shawCampbell/Light-and-Scent-repellent-system-to-deter-Honey-Badgers-from-the-Penguin-Colony/Group 31 Presentation Slides.pptx

## “How to keep predators, particularly honey badgers, away from the fence and the penguins??”

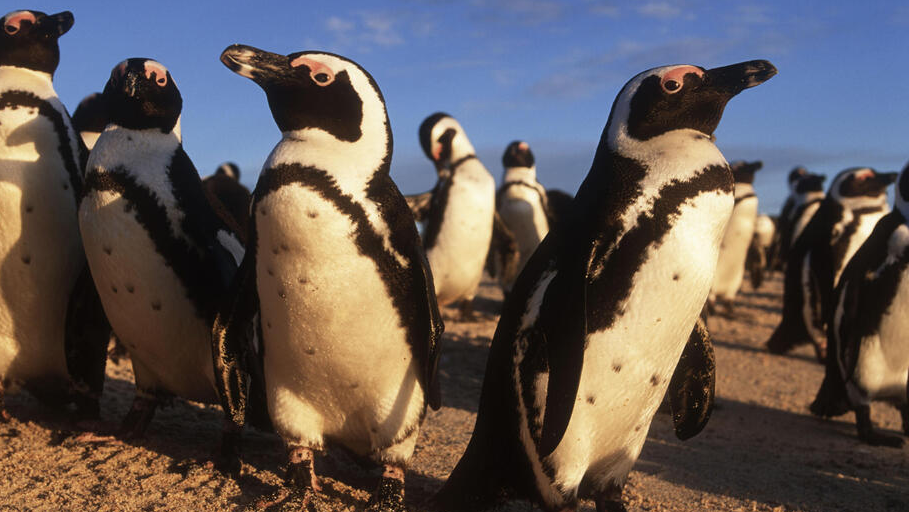
[picture p2: figure]

Group 31

## INSIGHT FROM THE LITERATURE

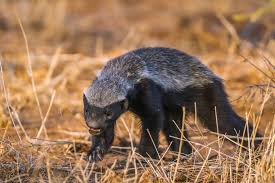
[picture p3: figure]
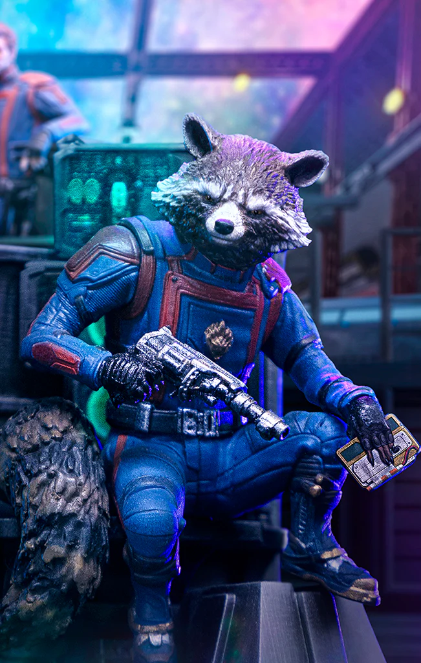
[picture p4: figure]

1. The world’s most fearless animal
2. Courageous, aggressive, strong and
SMART!!
Weaknesses:
1. Nocturnal
2. Heavily rely on smell for hunting
3. Repelled by certain scents e.g Citronella oil, garlic, vinegar etc

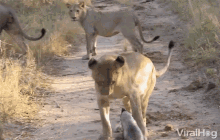
[picture p5: figure]

## Proposed solution: Honey Badger Repellent System

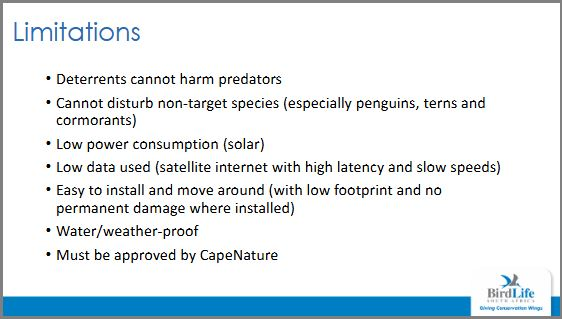
[picture p6: figure]

- Light and scent as a repellent
- Periodically spray the vicinity to desensitize the colony
- Once animal detected – turn on the strobing lights and power the spray

## Overview

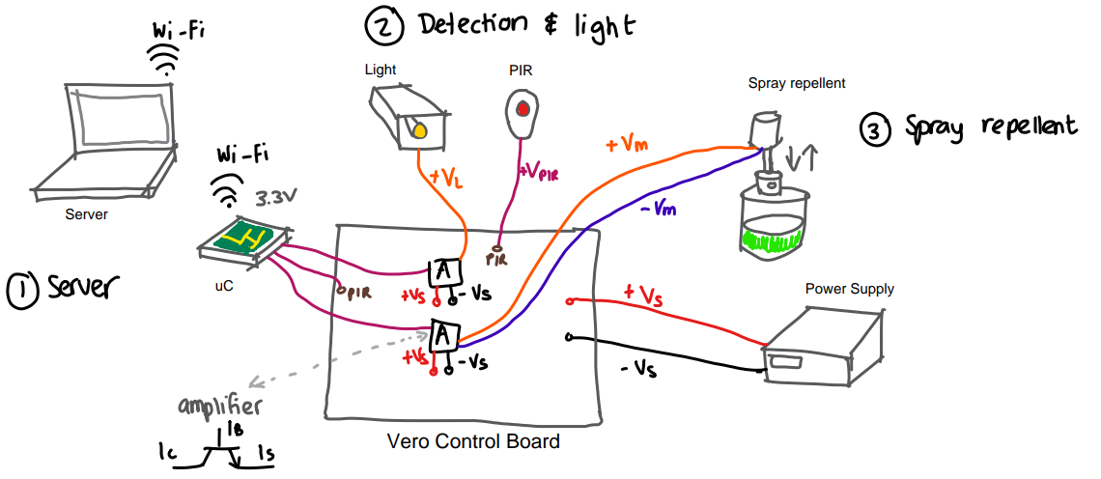
[picture p7: figure]

Overview of System

## Animal Detection Subsystem

Light sensor
*Power efficiency
*Increases electronics’ lifespan

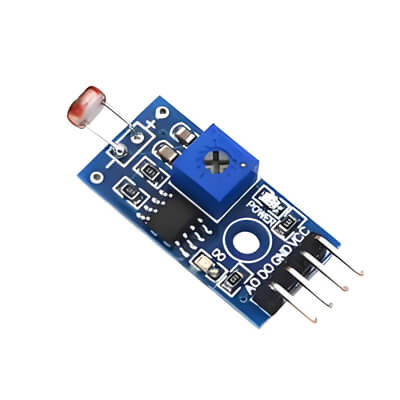
[picture p8: figure]

Passive Infrared (PIR)
*Common use in literature
*Long-range detection

IR Break beam sensor
* Short-range detection

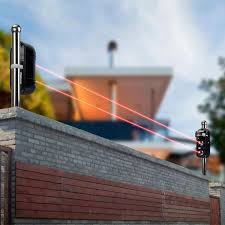
[picture p9: figure]
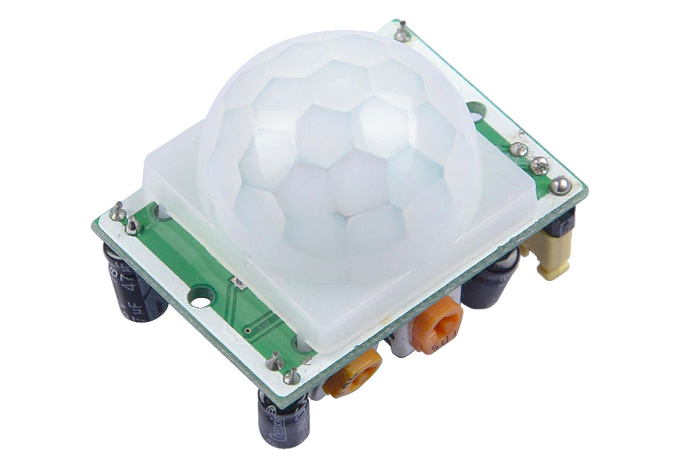
[picture p10: figure]

Sequential logic of operation:

Light sensor

PIR sensor

IR Break beam

ANIMAL DETECTED!!

## Networking and User Interface Subsystem

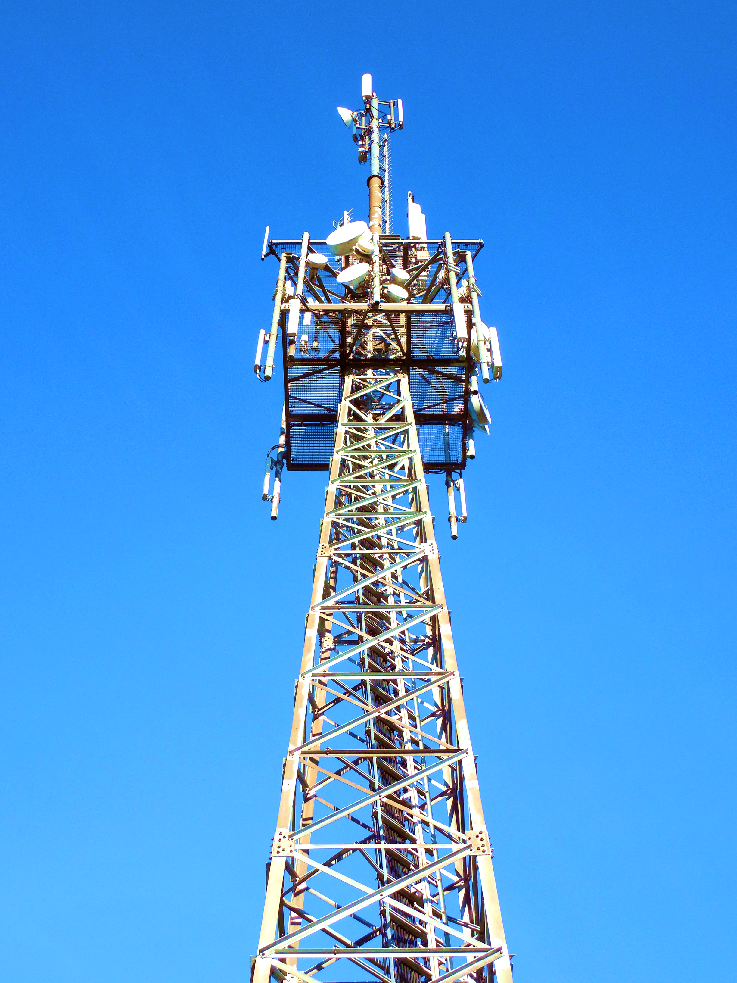
[picture p11: figure]
무료 이미지 : 변하기 쉬운, 범위, 차량, 탑, 돛대, 수신, 뉴스, 배달, 보내다, 전송 타워, 무선 기술, 송신기, 라디오 ...
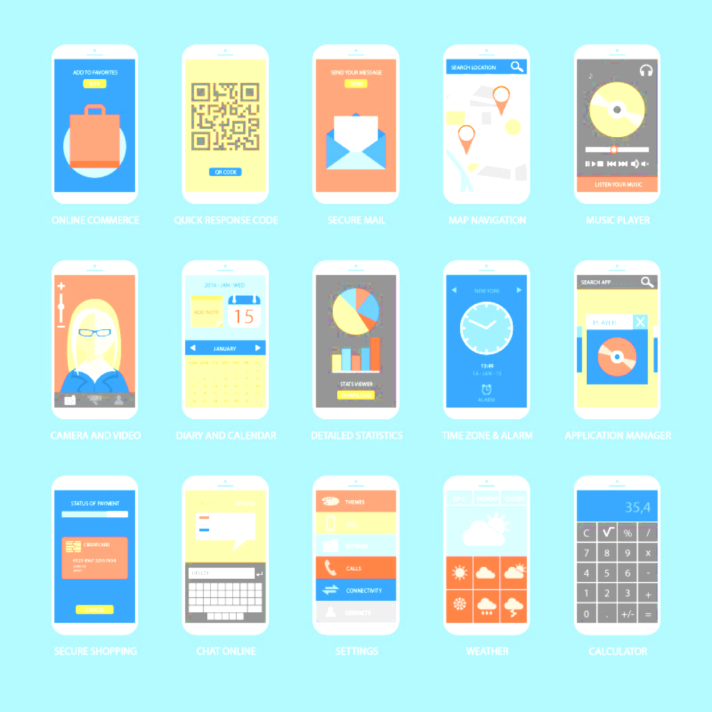
[picture p12: figure]
6 Necessary Elements For Designing A Perfect Mobile App User Interface ...
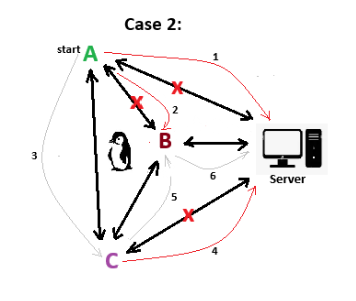
[picture p13: figure]
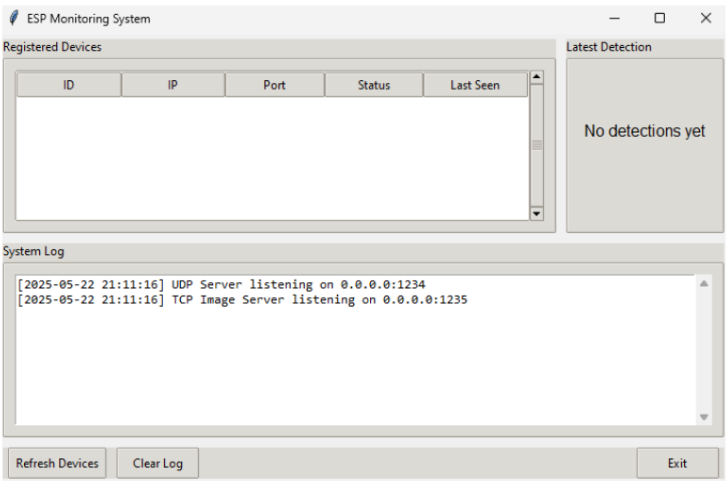
[picture p14: figure]

## Overview

- No machine learning
- No database
- Native web-application

UI must minimize
human error

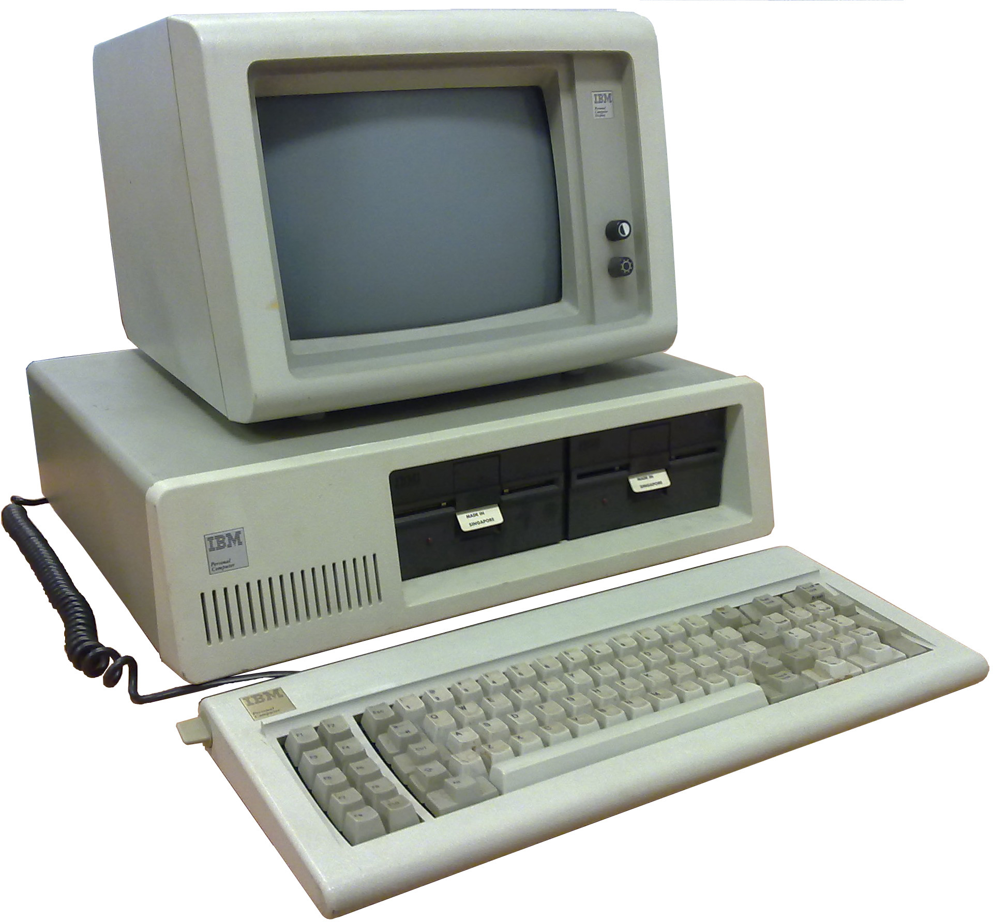
[picture p15: figure]
IBM’s First Personal Computer Was Released 34 Years Ago Today | Observer
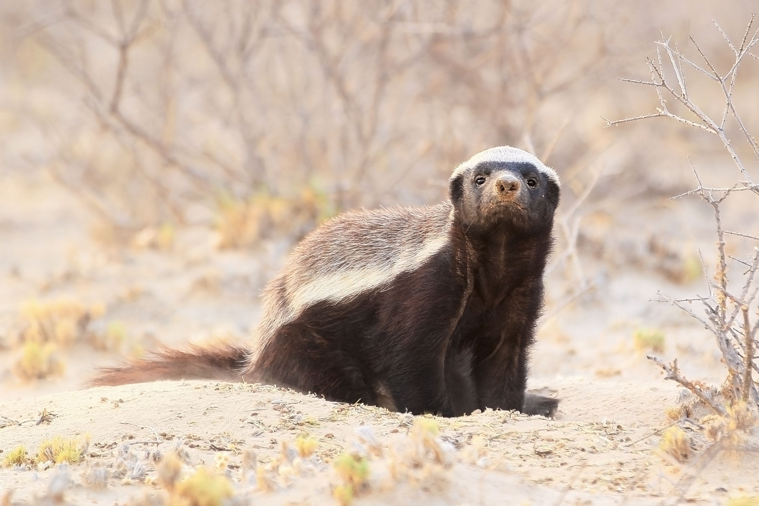
[picture p16: figure]
Honey Badger Facts (Mellivora capensis)
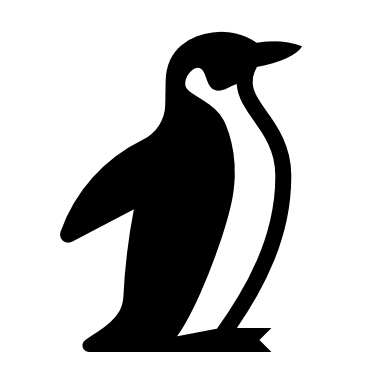
[picture p17: figure]
Penguin with solid fill
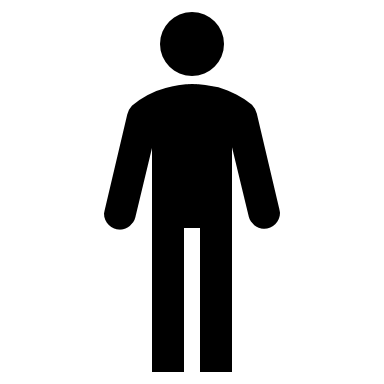
[picture p18: figure]
Man with solid fill

Human is the classifier, not machine learning

Overall System Architecture

## Main Goal is Reliability, Because Consequences are Severe

Drivers of Failure:

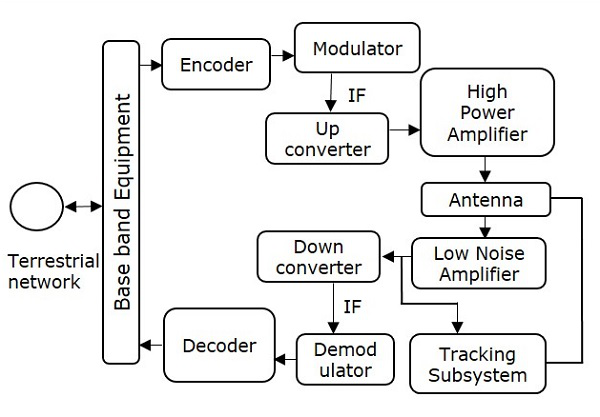
[picture p19: figure]

Wireless communication fails a lot

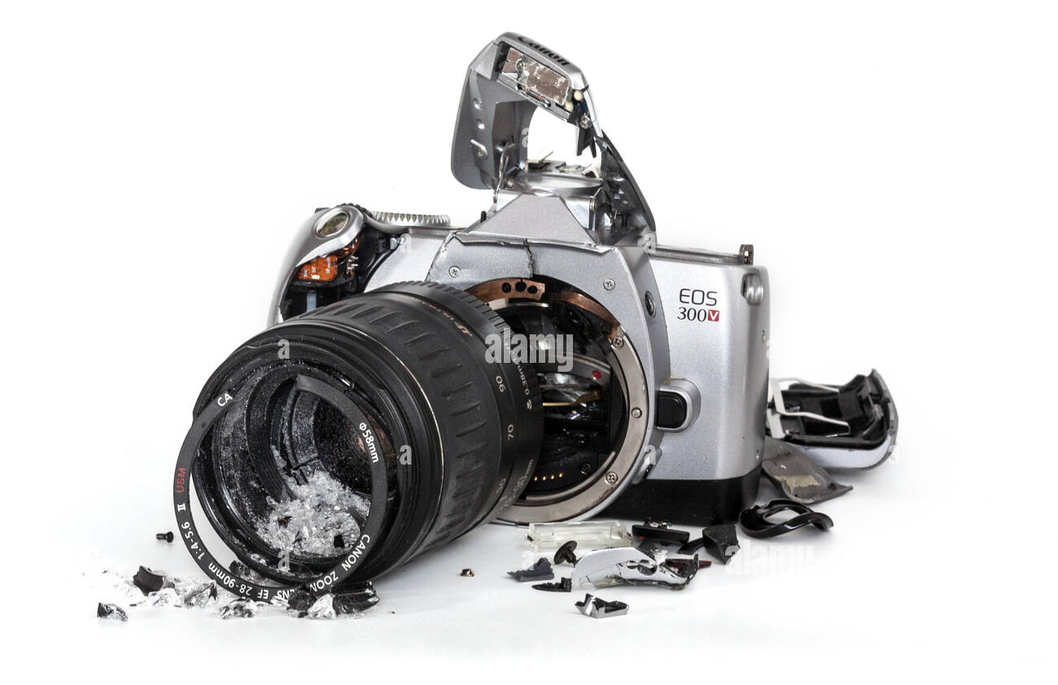
[picture p20: figure]
Smashed, broken Camera Stock Photo - Alamy

ESP32-cam suffers from frequent
camera malfunctions

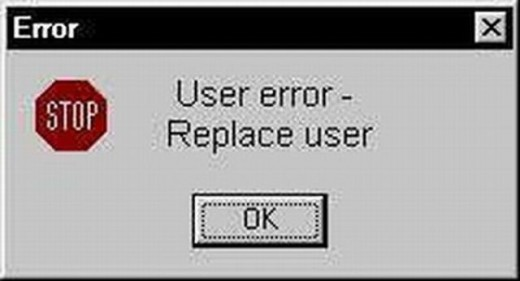
[picture p21: figure]

User's fail a lot, especially with bad UI

## Networking

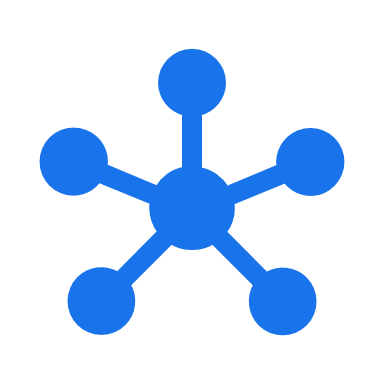
[picture p22: figure]
Network

## Networking Design

Application Layer Design

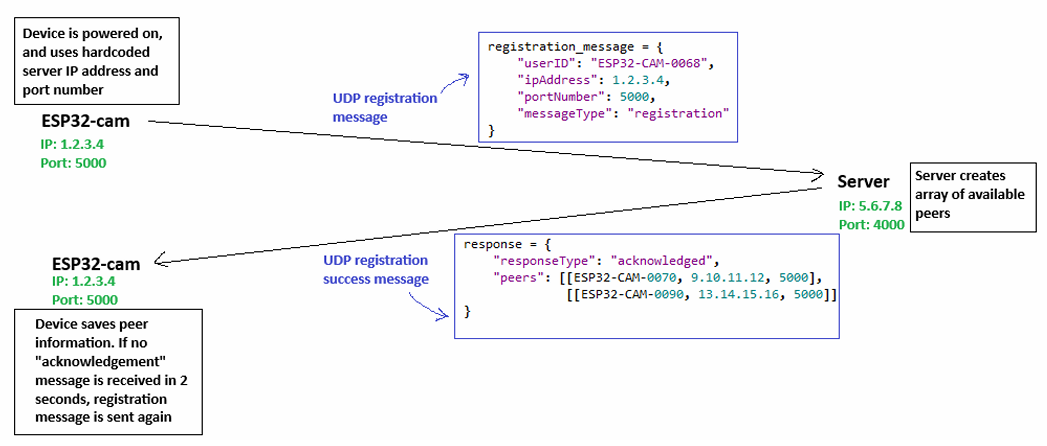
[picture p23: figure]

Correct Server Architecture

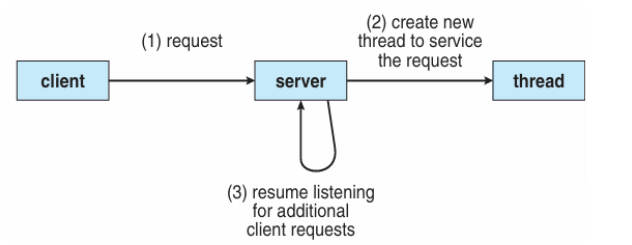
[picture p24: figure]
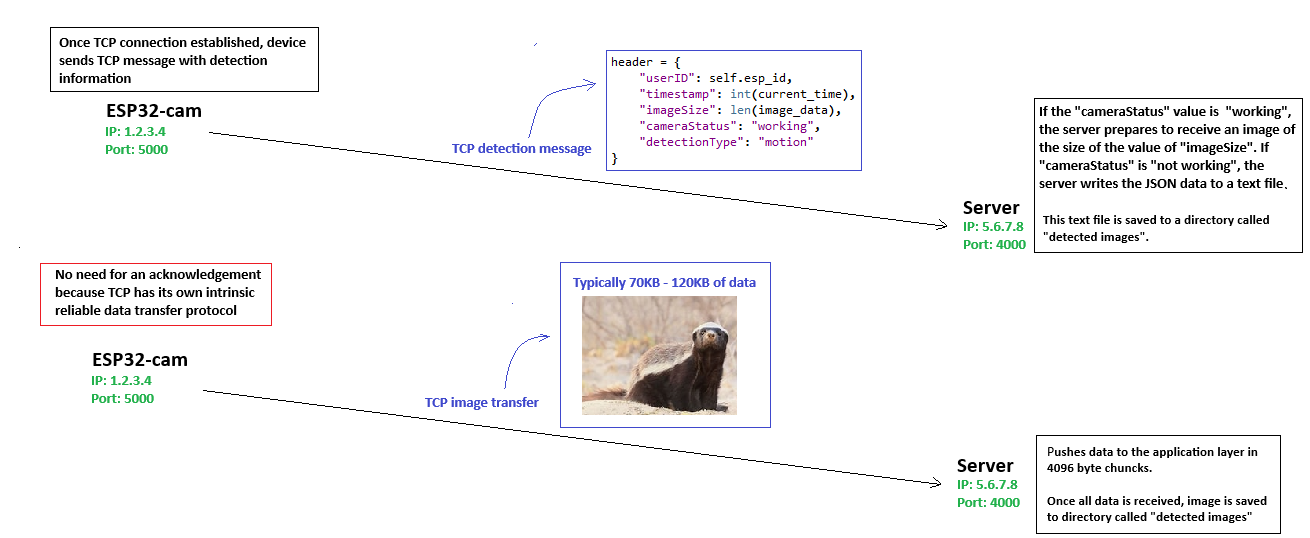
[picture p25: figure]

Message Structure and Protocol Design

Server Architecture

- Concurrency Issues
- Control signals vs data signals
- TCP and UDP

## Peer-to-peer Network

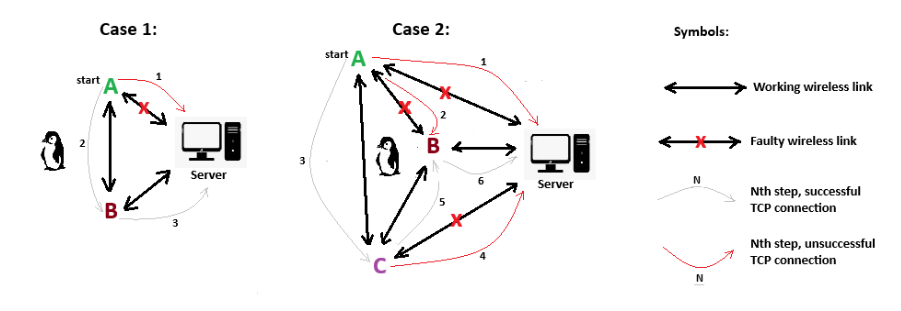
[picture p26: figure]

Peer-to-peer architecture

- Each ESP32-cam is BOTH A SERVER AND A CLIENT in this architecture
- Effectiveness scales with number of detection devices

## User-Interface

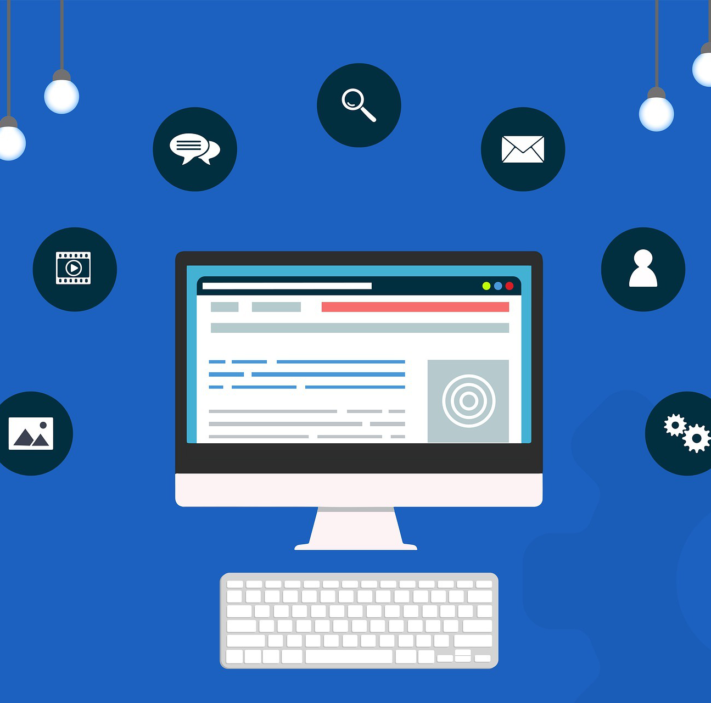
[picture p27: figure]
Pentingnya User Interface (UI) Serta 8 Karekteristik Yang Baik Untuk ...

## User-Interface Design: Idle

User-interface in Idle Mode

## Detection Event and Registered Devices

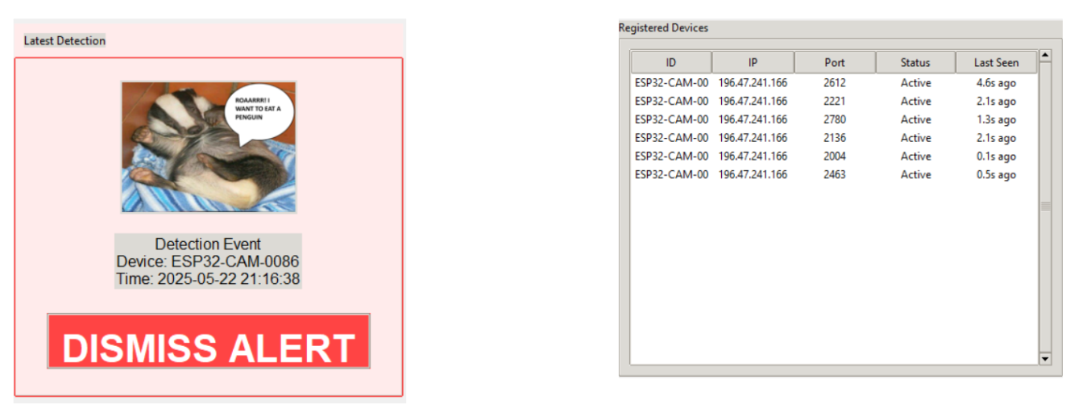
[picture p28: figure]

Registered Devices

Detection Alert

## System Log and Camera Broken Handling

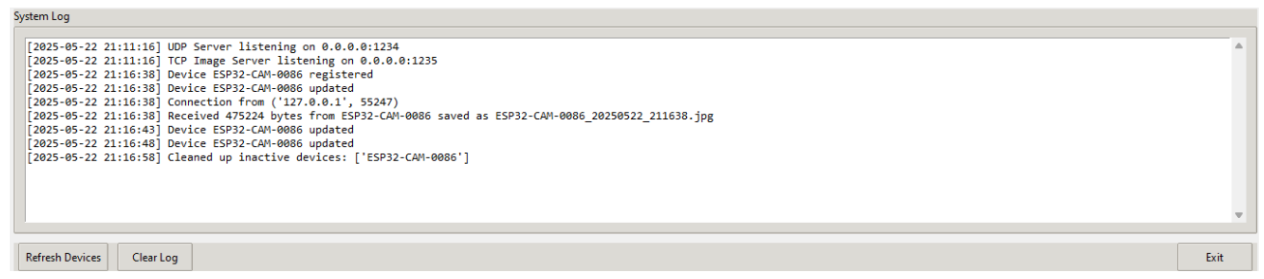
[picture p29: figure]

System Log

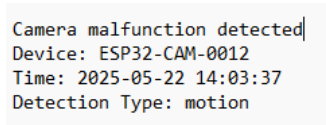
[picture p30: figure]

Data written for broken camera event, in a textfile
